wagiminator/ATtiny13-TinyDecoder/hardware/TinyDecoder_BOM.tsv

ID | Name | Designator | Footprint | Quantity | Manufacturer Part | Manufacturer | Supplier | Supplier Part
1 | MSK-11027 | KEY1 | SW_SMD_MSK-11027 | 1 | MSK-11027 Toggle Switches | ReliaPro | LCSC | C21381
2 | OLED 0.91 | OLED | I2C OLED 0.91 | 1 | SSD1306 I2C OLED
3 | 10R | R2 | 0603 | 1 | 0603WAF100JT5E | UniOhm | LCSC | C22859
4 | 10k | R1 | 0603 | 1 | 0603WAF1002T5E | UniOhm | LCSC | C25804
5 | ATtiny13A | U1 | SOP-8_150MIL | 1 | ATTINY13A-SSU | MICROCHIP | LCSC | C14075
6 | ICSP | H1 | ICSP-PADS-SMALL | 1 | MTP125-1203S1 | MINTRON | LCSC | C358692
7 | 100n | C1,C3 | 0603 | 2 | CC0603KRX7R9BB104 | YAGEO | LCSC | C14663
8 | 47u | C2 | 1206 | 1 | 1206F476M160NT | FH | LCSC | C30300
9 | TSOP4838 | U3 | TSOP18XX | 1 | TSOP4838 | VISHAY | LCSC | C124647
10 | CR1220 | B1 | CR1220-SMD | 1
