wagiminator/ATtiny13-TinyDecoder/hardware/TinyDecoder_schematic.pdf

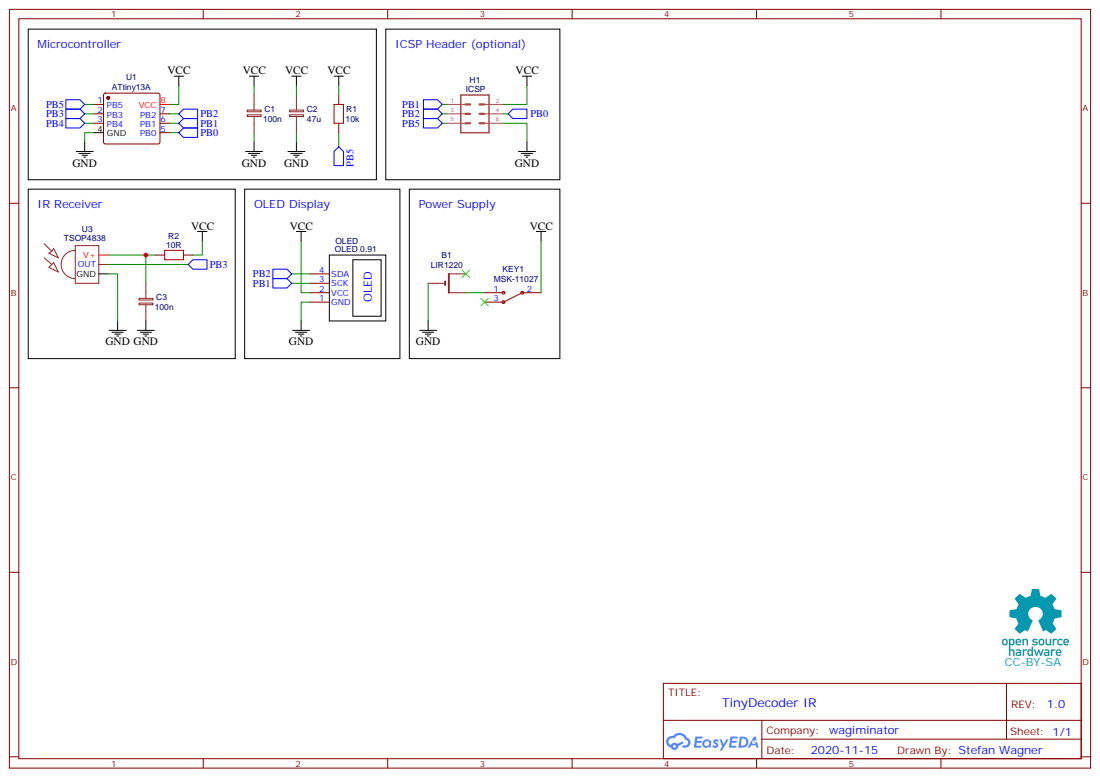
[picture p7: page 1]

Drawn By: Stefan Wagner
